simap/SaoScope/hardware/SaoScope.kicad_pcb

## KiCad design hardware/SaoScope.kicad_pcb (2024-10-12)

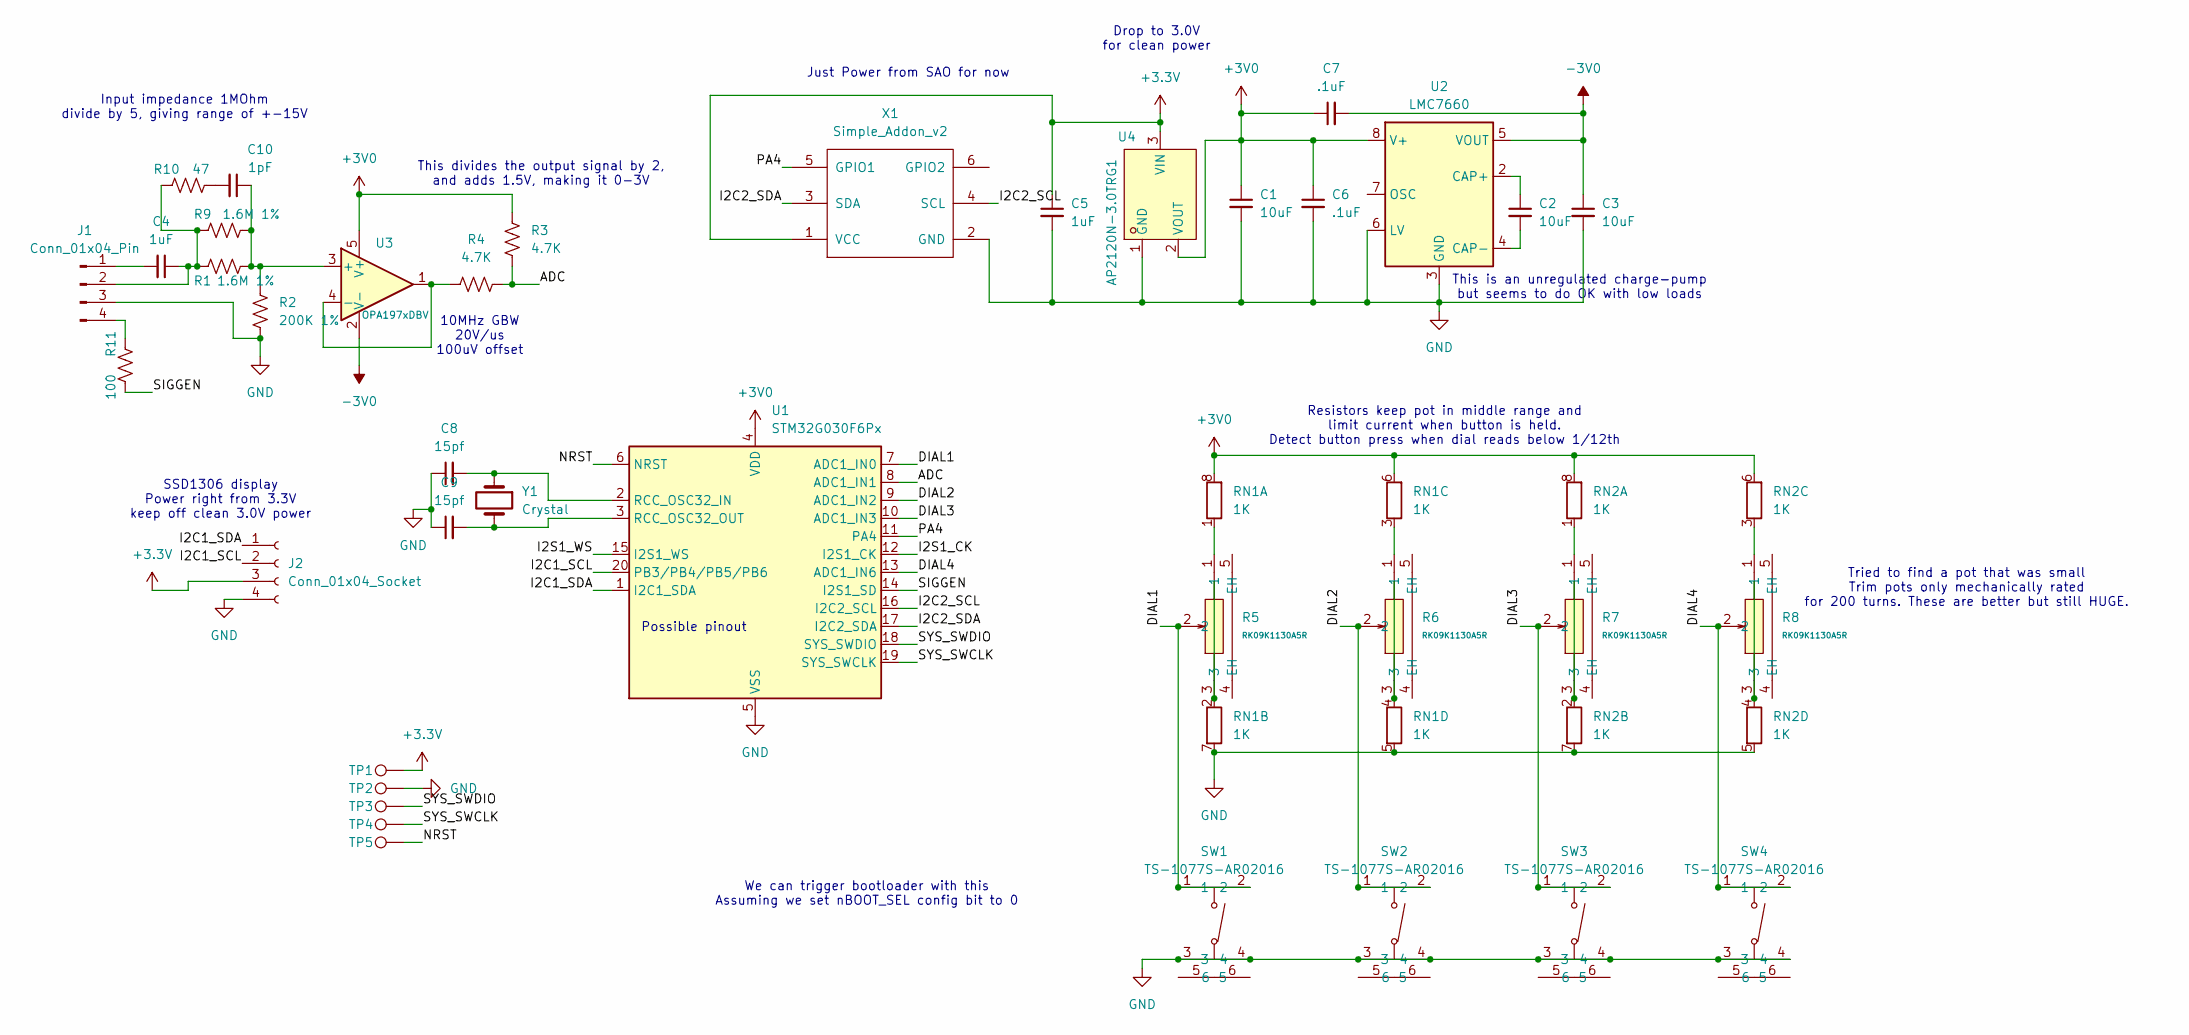
[picture p1: schematic SaoScope.kicad_sch]

Parts:
C1, C2, C3: 10uF; C_0805_2012Metric
C4, C5: 1uF; C_0603_1608Metric
C6, C7: .1uF; C_0402_1005Metric
C8, C9: 15pf; C_0402_1005Metric
C10: 1pF; C_0402_1005Metric
J1: Conn_01x04_Pin; PinHeader_1x04_P2.54mm_Vertical
J2: Conn_01x04_Socket; ssd1306_module
R1, R9: 1.6M 1%; R_0402_1005Metric; LCSC Part C172161
R2: 200K 1%; R_0402_1005Metric; LCSC Part C25764
R3, R4: 4.7K; R_0402_1005Metric
R5, R6, R7, R8: RK09K1130A5R; RES-ADJ-TH_RK09K1130A5R; LCSC Part C209779
R10: 47; R_0402_1005Metric; LCSC Part C172161
R11: 100; R_0402_1005Metric; LCSC Part C172161
RN1, RN2: 1K; R_Array_Convex_4x0402; LCSC Part C2769475
SW1, SW2, SW3, SW4: TS-1077S-AR02016; KEY-SMD_4P-L3.1-W3.1-P2.00-LS4.0; LCSC Part C720462
TP1, TP2, TP3, TP4, TP5: TestPoint; TestPoint_Pad_1.5x1.5mm
U1: STM32G030F6Px; TSSOP-20_4.4x6.5mm_P0.65mm
U2: LMC7660; SOP-8_3.9x4.9mm_P1.27mm
U3: OPA197xDBV; SOT-23-5
U4: AP2120N-3.0TRG1; SOT-23-3_L2.9-W1.3-P1.90-LS2.4-BR; LCSC Part C460318
X1: Simple_Addon_v2; Simple_Addon_v2-SAO-2x3
Y1: Crystal; Crystal_SMD_3215-2Pin_3.2x1.5mm; LCSC Part C5213671

Connections:
+3.3V: C5.1, J2.3, TP1.1, U4.3 (VIN), X1.1 (VCC)
+3V0: C1.1, C6.1, C7.1, R3.2, RN1.6 (R3.2), RN1.8 (R1.2), RN2.6 (R3.2), RN2.8 (R1.2), U1.4 (VDD), U2.8 (V+), U3.5 (V+), U4.2 (VOUT)
-3V0: C3.1, C7.2, U2.5 (VOUT), U3.2 (V-)
/ADC: R3.1, R4.2, U1.8 (ADC1_IN1)
/DIAL1: R5.2, SW1.1, SW1.2, U1.7 (ADC1_IN0)
/DIAL2: R6.2, SW2.1, SW2.2, U1.9 (ADC1_IN2)
/DIAL3: R7.2, SW3.1, SW3.2, U1.10 (ADC1_IN3)
/DIAL4: R8.2, SW4.1, SW4.2, U1.13 (ADC1_IN6)
/I2C1_SCL: J2.2, U1.20 (PB3/PB4/PB5/PB6)
/I2C1_SDA: J2.1, U1.1 (I2C1_SDA)
/I2C2_SCL: U1.16 (I2C2_SCL), X1.4 (SCL)
/I2C2_SDA: U1.17 (I2C2_SDA), X1.3 (SDA)
/I2S1_CK: U1.12 (I2S1_CK)
/I2S1_WS: U1.15 (I2S1_WS)
/NRST: TP5.1, U1.6 (NRST)
/PA4: U1.11 (PA4), X1.5 (GPIO1)
/SIGGEN: R11.2, U1.14 (I2S1_SD)
/SYS_SWCLK: TP4.1, U1.19 (SYS_SWCLK)
/SYS_SWDIO: TP3.1, U1.18 (SYS_SWDIO)
GND: C1.2, C3.2, C5.2, C6.2, C8.1, C9.1, J1.3, J2.4, R2.2, RN1.5 (R4.2), RN1.7 (R2.2), RN2.5 (R4.2), RN2.7 (R2.2), SW1.3, SW1.4, SW2.3, SW2.4, SW3.3, SW3.4, SW4.3, SW4.4, TP2.1, U1.5 (VSS), U2.3 (GND), U2.6 (LV), U4.1 (GND), X1.2 (GND)
unnamed: C10.2, R10.2
unnamed: C4.2, J1.1
unnamed: C4.1, J1.2, R1.1, R9.1, R10.1
unnamed: J1.4, R11.1
unnamed: R5.1, RN1.1 (R1.1)
unnamed: R5.3, RN1.2 (R2.1)
unnamed: R6.1, RN1.3 (R3.1)
unnamed: R6.3, RN1.4 (R4.1)
unnamed: R7.1, RN2.1 (R1.1)
unnamed: R7.3, RN2.2 (R2.1)
unnamed: R8.1, RN2.3 (R3.1)
unnamed: R8.3, RN2.4 (R4.1)
unnamed: C8.2, U1.2 (RCC_OSC32_IN), Y1.1
unnamed: C9.2, U1.3 (RCC_OSC32_OUT), Y1.2
unnamed: C2.1, U2.2 (CAP+)
unnamed: C2.2, U2.4 (CAP-)
unnamed: C10.1, R1.2, R2.1, R9.2, U3.3 (+)
unnamed: R4.1, U3.1, U3.4 (-)

Notes on the sheet:
We can trigger bootloader with this Assuming we set nBOOT_SEL config bit to 0
Resistors keep pot in middle range and limit current when button is held. Detect button press when dial reads below 1/12th
This divides the output signal by 2, and adds 1.5V, making it 0-3V
SSD1306 display Power right from 3.3V keep off clean 3.0V power
Just Power from SAO for now
Tried to find a pot that was small Trim pots only mechanically rated for 200 turns. These are better but still HUGE.
Drop to 3.0V for clean power
This is an unregulated charge-pump but seems to do OK with low loads
Possible pinout
Input impedance 1MOhm divide by 5, giving range of +-15V
10MHz GBW 20V/us 100uV offset

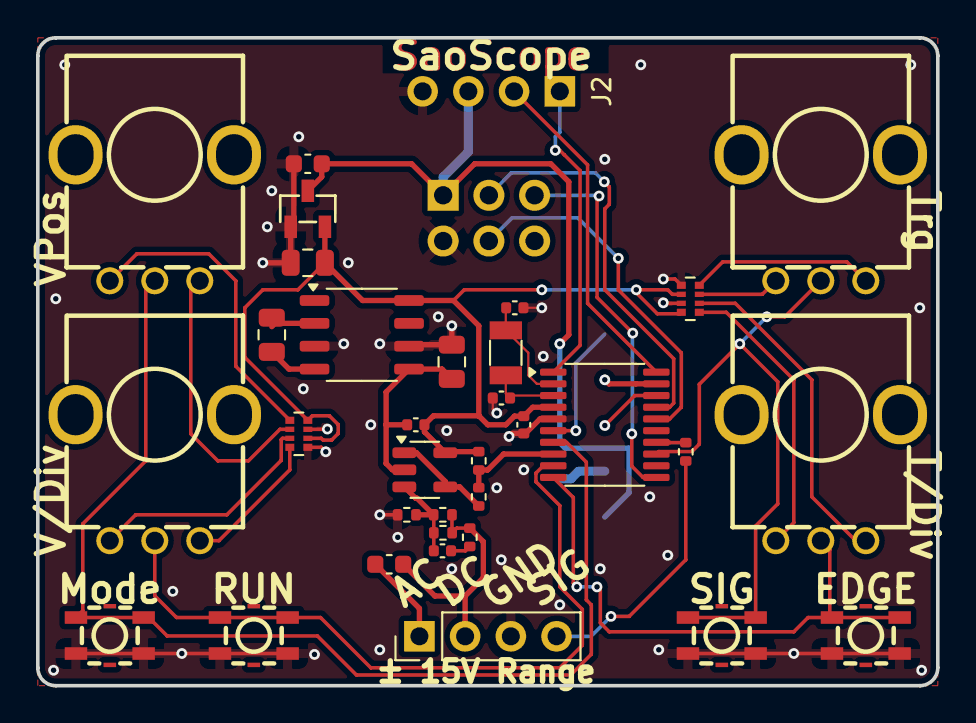
[picture p2: board SaoScope.kicad_pcb from above]

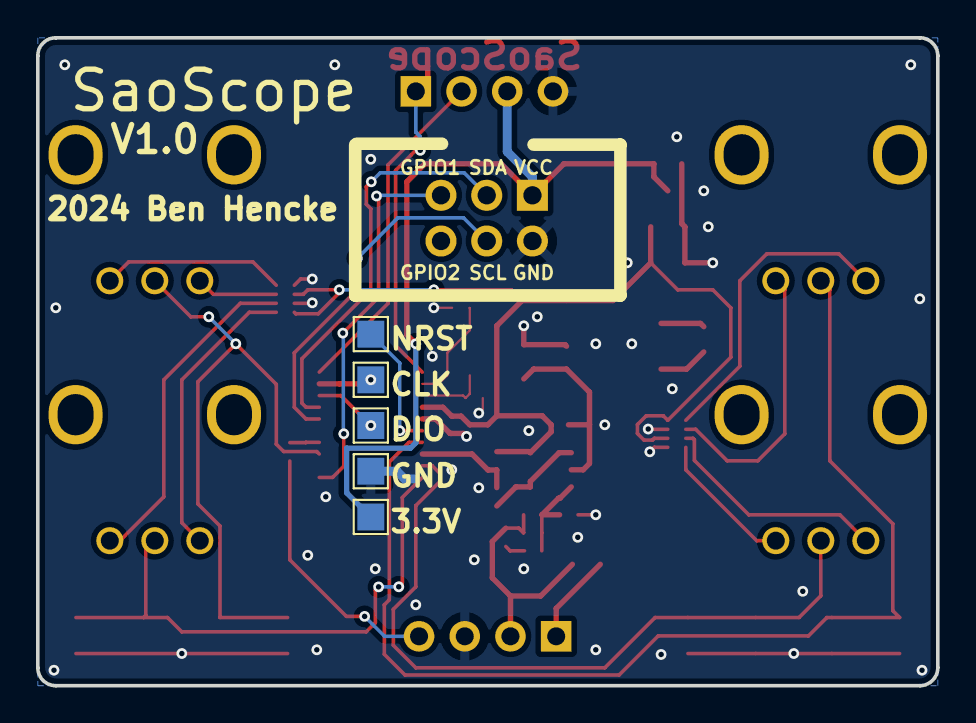
[picture p3: board SaoScope.kicad_pcb from below]

Board: 2 copper layers, 50.0 x 36.0 mm, 40 parts (5 on the bottom side), 36 nets.
