simap/SaoScope/firmware/SaoScope.ioc

Mcu.UserName=STM32G030F6Px
PA0.GPIO_Label=DIAL1
PA0.Signal=ADC1_IN0
PA1.GPIO_Label=SCOPE
PA1.Signal=ADC1_IN1
PA13.Signal=SYS_SWDIO
PA14-BOOT0.Signal=SYS_SWCLK
PA2.GPIO_Label=DIAL2
PA2.Signal=ADC1_IN2
PA3.GPIO_Label=DIAL3
PA3.Signal=ADC1_IN3
PA4.Signal=GPIO_Input
PA5.Signal=I2S1_CK
PA6.GPIO_Label=DIAL4
PA6.Signal=ADC1_IN6
PA7.Signal=SharedStack_PA7
PB0.Signal=I2S1_WS
PB6.Signal=I2C1_SCL
PB7.Signal=I2C1_SDA
