simap/SaoScope/firmware/Core/Inc/main.h

#define DIAL1_Pin LL_GPIO_PIN_0
#define DIAL1_GPIO_Port GPIOA
#define SCOPE_Pin LL_GPIO_PIN_1
#define SCOPE_GPIO_Port GPIOA
#define DIAL2_Pin LL_GPIO_PIN_2
#define DIAL2_GPIO_Port GPIOA
#define DIAL3_Pin LL_GPIO_PIN_3
#define DIAL3_GPIO_Port GPIOA
#define DIAL4_Pin LL_GPIO_PIN_6
#define DIAL4_GPIO_Port GPIOA
