simap/SaoScope/firmware/Core/Src/app.c

/*
 * app.c
 *
 *  Created on: Dec 7, 2022
 *      Author: benh
 */

#include "main.h"
#include "app.h"

#include "ssd1306.h"
#include "ssd1306_tests.h"

#include "sampler.h"
#include "scope.h"
#include "button.h"
#include "dial.h"

#include "stdio.h"

Sampler sampler;
ScopeSettings scope;
ButtonState modeButton, runButton, edgeButton, signalButton;
DialState vposDial, vdivDial, tdivDial, triggerDial;
volatile uint32_t ticks;
uint32_t vdd;

const uint32_t nsDivSequence[] = {500, 1000, 2000, 5000, 10000, 20000, 50000, 100000, 200000, 500000, 1000000, 2000000, 5000000, 10000000};
const uint32_t signalGenFrequencies[] = {20, 50, 100, 200, 500, 1000, 2000, 5000, 10000, 20000, 50000, 100000, 200000, 500000};
const uint32_t vdivStepsMv[] = {100, 200, 500, 1000, 2000, 5000};

int signalGenIndex = 7;
uint32_t messageTimer;
char message[32];

uint32_t getCycles() {
	return SysTick->VAL;
}

void systickISR() {
	ticks++;
	adcManagerSystickISR();
}

uint32_t getTicks() {
	return ticks;
}

void delay(uint32_t ms) {
	uint32_t timer = ticks;
	while (ticks - timer < ms) {
		//wait
	}
}

void delayCycles(uint32_t c) {
	uint32_t timer = SysTick->VAL;
	while (SysTick->VAL - timer < c) {
		//wait
	}
}


void displayMessage(char *msg) {
	strncpy(message, msg, sizeof(message));
	messageTimer = ticks;
}


void displayTriggerLevelMessage() {
	if (abs(scope.triggerLevelUv) < 1000000)
		snprintf(message, sizeof(message), "Trg:  %4dmV", scope.triggerLevelUv/1000);
	else
		snprintf(message, sizeof(message), "Trg:%3d.%02dV", scope.triggerLevelUv/1000000, abs(scope.triggerLevelUv/10000) % 100);
	messageTimer = ticks;
}

void displaySignalGenMessage() {
	int freq = signalGenFrequencies[signalGenIndex];
	if (freq < 1000)
		snprintf(message, sizeof(message), "Sig: %3dHz", freq);
	else
		snprintf(message, sizeof(message), "Sig: %3dKHz", freq/1000);
	messageTimer = ticks;
}

void displayVdivMessage(int vdivMv) {
	if (vdivMv < 1000)
		snprintf(message, sizeof(message), "V/div:  %3dmV", vdivMv);
	else
		snprintf(message, sizeof(message), "V/div: %3d.%02dV", vdivMv/1000, (vdivMv/10) % 100);
	messageTimer = ticks;
}

void run() {

	//pause all peripherals and clocks in debug
	DBG->APBFZ1 = 0xffffffff;
	DBG->APBFZ2 = 0xffffffff;



	scope.mode = CONTINUOUS;
	scope.runMode = RUNNING;


	buttonInit(&modeButton, BUTTON_DEBOUNCE_COUNT, BUTTON_HOLD_COUNT);
	buttonInit(&runButton, BUTTON_DEBOUNCE_COUNT, BUTTON_HOLD_COUNT);
	buttonInit(&edgeButton, BUTTON_DEBOUNCE_COUNT, BUTTON_HOLD_COUNT);
	buttonInit(&signalButton, BUTTON_DEBOUNCE_COUNT, BUTTON_HOLD_COUNT);

	dialInit(&vposDial, 0x8000, 3500, 100);
	dialInit(&vdivDial, 0x8000, 3500, 100);
	// dialInit(&tdivDial, 0x8000, 3500, 100);
	dialInit(&tdivDial, 0x8000, 3500, sizeof(nsDivSequence)/sizeof(nsDivSequence[0]));

	dialInit(&triggerDial, 0x8000, 3500, 256);


	LL_SYSTICK_EnableIT();

	delay(10);

	initSampler(&sampler);
	adcManagerSetup();

	//set up TIM14 signal generation on PA7
	LL_GPIO_SetPinSpeed(GPIOA, LL_GPIO_PIN_7, LL_GPIO_SPEED_FREQ_VERY_HIGH);
	LL_GPIO_SetPinMode(GPIOA, LL_GPIO_PIN_7, LL_GPIO_MODE_ALTERNATE);
	LL_GPIO_SetAFPin_0_7(GPIOA, LL_GPIO_PIN_7, LL_GPIO_AF_4); //set to TIM14_CH1

	LL_TIM_OC_SetMode(TIM14, LL_TIM_CHANNEL_CH1, LL_TIM_OCMODE_PWM1);

    setSignalGen();

    LL_TIM_EnableAllOutputs(TIM14);
	LL_TIM_CC_EnableChannel(TIM14, LL_TIM_CHANNEL_CH1);
	LL_TIM_EnableCounter(TIM14);


	//HACK speed up i2c, well above spec, but it works. about 1.25mhz
	LL_I2C_Disable(I2C1);
	LL_I2C_SetTiming(I2C1, __LL_I2C_CONVERT_TIMINGS(
			0, //PRESCALER
			1, //SETUP_TIME
			0, //HOLD_TIME
			6, //SCLH_PERIOD
			12 //SCLL_PERIOD
	));
	LL_I2C_Enable(I2C1);


	ssd1306_Init();
	ssd1306_SetContrast(0xff);


    int frame = 0;
    uint32_t frameTimer = ticks;
    volatile int fps = 0;
    int pwm;
	uint32_t rate = 1750000;
	int32_t sampleScale = 0x10000;
	int32_t vdivScale = 0x10000;
	int32_t vdivMv, vdivValue;
	int vposOffset = 0;

	SSD1306_COLOR flickering = White;

    for(;;) {
		adcManagerLoop();
//		ssd1306_TestFPS();

    	if (ticks - frameTimer >= 1000) {
    		fps = frame;
    		frameTimer += 1000;
    		frame = 0;
    	}

		if (dialPollChangeEvent(&tdivDial)) {
			int tmp = tdivDial.steps - dialGetValue(&tdivDial) - 1;
			// tmp = (tmp * tmp)/96;
			// rate = tmp * 17500;

			// rate = tmp * tmp * 175;

			//tdiv is ns per 16 samples, convert this to hz
			rate = 16000000000l / nsDivSequence[tmp];

			// if (rate < 13672)
			// 	rate = 13672;
			// if (rate > 1750000)
			// 	rate = 1750000;
			
			setSampleRate(&sampler, rate > 1750000 ? 1750000 : rate); //for now, limit rate until we have everything set up to handle different bit depths
			//TODO scope stepping is usually 1, 2, 5, 10, 20, 50, 100, etc. thats a step of 2x, 2.5x, 2x, 2x, 2.5x, 2x, etc
		}

		sampleScale = ((int64_t)sampler.snapshotSampleRate<<16) / rate;

		if (dialPollChangeEvent(&vposDial)) {
			int32_t tmp = dialGetValue(&vposDial);
			tmp -= vposDial.steps/2;
			vposOffset = 32 + (abs(tmp) * tmp / 4);
		}
		
		if (dialPollChangeEvent(&vdivDial)) {
			int tmp = dialGetValue(&vdivDial);
			// tmp = tmp*tmp;
			if (tmp < 1)
				tmp = 1;
			vdivScale = (0x20000) / tmp;

			//at this scale, how many mv/div are we showing in 16 pixels?
			volatile int mv = adcToUv((16<<16) / vdivScale + 2047) / 1000;

			//find the closest mv/div setting for this scale, shooting for 16 pixels per div. 
			int best = 0;
			int bestDiff = INT32_MAX;
			for (int i = 0; i < sizeof(vdivStepsMv)/sizeof(vdivStepsMv[0]); i++) {
				int diff = abs(vdivStepsMv[i] - mv);
				if (diff < bestDiff) {
					bestDiff = diff;
					best = i;
				}
			}
			vdivMv = vdivStepsMv[best];
			vdivValue = uvToAdc(vdivMv * 1000) - 2047;
			// displayVdivMessage(vdivMv);
		}



		// int vdiv = dialGetValue(&vdivDial);
		// int vpos = dialGetValue(&vposDial);

		
		if (1) {
			int32_t tmp = triggerDial.steps - dialGetValue(&triggerDial);
			tmp -= triggerDial.steps/2;
			//use an exponential scale to get a more useful range. on the top we need +- 15v
			//tmp^2 is up to 16384
			scope.triggerLevelUv = abs(tmp) * tmp * (15000000 / 16384);
		}
		if (dialPollChangeEvent(&triggerDial)) {
			displayTriggerLevelMessage();
		}
		int triggerSampleValue = uvToAdc(scope.triggerLevelUv) - 2048;
		// int triggerValue = dialGetValue(&triggerDial) * 40 - 2048;
		

		if (buttonPollClickEvent(&runButton)) {
			scope.runMode = scope.runMode == STOPPED ? RUNNING : STOPPED;
		}

		if (buttonPollClickEvent(&modeButton)) {
			int next = scope.mode + 1;
			if (next > SINGLE)
				next = CONTINUOUS;
			setScopeMode(next);
		}

		if (buttonPollClickEvent(&edgeButton)) {
			scope.triggerSlope = scope.triggerSlope == RISING ? FALLING : RISING;
		}

		if (buttonPollClickEvent(&signalButton)) {
			signalGenIndex++;
			if (signalGenIndex >= sizeof(signalGenFrequencies)/sizeof(signalGenFrequencies[0]))
				signalGenIndex = 0;
			setSignalGen();
			displaySignalGenMessage();
		}

		//draw scope

        ssd1306_Fill(Black);

		int32_t minVoltage = INT32_MAX;
		int32_t maxVoltage = INT32_MIN;


		//refine edge detection
#if 1
		int start = -1;
		for (int x = SAMPLE_BUFFER_SIZE/2 - 20; x < SAMPLE_BUFFER_SIZE/2 + 20; x++) {
			int sample = getSample(&sampler, x);

			if (scope.triggerSlope == RISING) {
				if (start == -1 && sample < triggerSampleValue) {
					start = x;
				}

				if (start >= 0 && sample > triggerSampleValue) {
					start = x;
					break;
				}
			} else {
				if (start == -1 && sample > triggerSampleValue) {
					start = x;
				}

				if (start >= 0 && sample < triggerSampleValue) {
					start = x;
					break;
				}
			}
			
		}

		if (start < 64 || start > 800)
			start = 512;
#else
		int start = SAMPLE_BUFFER_SIZE/2;
#endif

		start -= (64 * sampleScale) >> 16;
		// start -= 64;


		SSD1306_COLOR blink = (getTicks() & 0x80) ? White : Black;
		flickering = (getTicks() & 0x20) ? White : Black;
		
		for (int x = 0; x < SSD1306_WIDTH; x++) {
			int32_t graphSamplePosition = (x * sampleScale) + (start<<16);
			if (graphSamplePosition < 0)
				continue;
			if (graphSamplePosition >> 16 >= SAMPLE_BUFFER_SIZE -1)
				break;
			int sample = getInterpolatedSample(&sampler, graphSamplePosition);

			// int sample = getSample(&sampler, x + start);
			int mv = 15000 * sample / 2048;

			if (mv > maxVoltage)
				maxVoltage = mv;
			if (mv < minVoltage)
				minVoltage = mv;

			// int y = vpos - sample/vdiv;
			int y = vposOffset - ((sample * vdivScale) >> 16);

//				int y = 31 - sample/100;
			SSD1306_COLOR color = White;
			if (y > 63) {
				y = 63;
				color = blink;
			} else if (y < 0) {
				y = 0;
				color = blink;
			}
			ssd1306_DrawPixel(x, y , color);
		}



		//draw center line showing trigger time
		// for (int y = 0; y < 48; y += 8) {
		// 	ssd1306_DrawPixel(64, y, flickering);
		// 	// ssd1306_DrawPixel(0, y, flickering);
		// 	// ssd1306_DrawPixel(127, y, flickering);
		// }

		//draw vdiv dots
		for (int i = -5; i < 5; i++) {
			int yOffset = ((i * vdivValue * vdivScale) >> 16);
			// ssd1306_DrawPixel(64, vposOffset - yOffset, White);

			//draw these every 16 pixels, 8 for ground line
			int increment = i == 0 ? 8: 16;
			for (int x = 0; x < 128; x += increment) {
				int y = vposOffset - yOffset;
				if (y > 56) //skip area with text
					continue;
				ssd1306_DrawPixel(x, y, flickering);
			}
		}

		//draw trigger threshold line
		{
			int y = vposOffset - ((triggerSampleValue * vdivScale) >> 16);
			for (int x = 0; x < SSD1306_WIDTH; x += 4) {
				// ssd1306_DrawPixel(x, vpos - triggerValue/vdiv, flickering);
				//now from triggerLevelUv. convering microvolts to ADC value
				// int y = vposOffset - triggerSampleValue/vdiv;
				ssd1306_DrawPixel(x, y, flickering);
			}
		}

		// //draw ground line every 8 pixels
		// for (int x = 0; x < 128; x += 8) {
		// 	ssd1306_DrawPixel(x, vposOffset, White);
		// }





    	// if (run) {
    	// 	startSampler(&sampler);
    	// }

		/* screen design, 21 chars wide

		|---------------------|
		| plot area		      | y = 0-7
		|                     | y = 8-15
		|                     | y = 16-23
		|                     | y = 24-31
		|                     | y = 32-39
		|                     | y = 40-47
		|< messages | stats  >| y = 48-55
		|1.0v 100ms  SCAN R _/|	y = 56-63
		|---------------------|

		*/

		char buff[64];

		const int yStart = 48;
		ssd1306_SetCursor(1, yStart);

		// ssd1306_FillRectangle(0, 15 + yStart, 127, 32 + yStart, White);
		int Vp = (maxVoltage - minVoltage)/10;
		int VpVolts = Vp/100;
		int VpHv = (Vp - VpVolts*100);

		if (message[0] != 0) {
			if (ticks - messageTimer < 2000) {
				ssd1306_WriteString(message, Font_6x8, White);
			} else {
				message[0] = 0;
			}
		} else {
			//TODO show stats, like Vp, Vrms, frequency, etc
			// snprintf(buff, sizeof(buff), "Vdd:%dmv  FPS: %d", vdd, fps);
			// ssd1306_WriteString(buff, Font_6x8, White);
		}

		//show key scope settings
		


		// snprintf(buff, sizeof(buff), "%d, %d, %d, %d ", dialGetValue(&vposDial), dialGetValue(&vdivDial), dialGetValue(&tdivDial), dialGetValue(&triggerDial));
		// ssd1306_SetCursor(1, 24 + yStart);
		// ssd1306_WriteString(buff, Font_6x8, White);

		// ssd1306_WriteString(modeButton.isHeld ? "H" : modeButton.isDown ? "O" : "-", Font_6x8, White);
		// ssd1306_WriteString(runButton.isHeld ? "H" : runButton.isDown ? "O" : "-", Font_6x8, White);
		// ssd1306_WriteString(edgeButton.isHeld ? "H" : edgeButton.isDown ? "O" : "-", Font_6x8, White);
		// ssd1306_WriteString(signalButton.isHeld ? "H" : signalButton.isDown ? "O" : "-", Font_6x8, White);


		ssd1306_SetCursor(1, 8 + yStart);

		const char * modeStr = scope.mode == CONTINUOUS ? "SCAN" : scope.mode == NORMAL ? "NORM" : "SING";
		const char * runStr = scope.runMode == STOPPED ? "S" : "R";
		const char * edgeStr = scope.triggerSlope == RISING ? "_/" : "\\_";

		ssd1306_WriteString(modeStr, Font_6x8, White);
		ssd1306_WriteString(" ", Font_6x8, White);
		ssd1306_WriteString(runStr, Font_6x8, scope.runMode == STOPPED ? blink : White);
		ssd1306_WriteString(" ", Font_6x8, White);
		// snprintf(buff, sizeof(buff), "~%dmv", scope.triggerLevelUv/1000);
		// ssd1306_WriteString(buff, Font_6x8, White);

		int nsdiv = 16000000000l / rate;
		if (nsdiv < 1000) {
			snprintf(buff, sizeof(buff), "%dns", nsdiv);
		} else if (nsdiv < 1000000) {
			snprintf(buff, sizeof(buff), "%dus", nsdiv/1000);
		} else {
			snprintf(buff, sizeof(buff), "%dms", nsdiv/1000000);
		}
		ssd1306_WriteString(buff, Font_6x8, White);

		if (vdivMv < 1000)
			snprintf(buff, sizeof(buff), " .%dV", vdivMv/100);
		else
			snprintf(buff, sizeof(buff), " %dV", vdivMv/1000);
		ssd1306_WriteString(buff, Font_6x8, White);

		ssd1306_SetCursor(112, 8 + yStart);
		ssd1306_WriteString(edgeStr, Font_6x8, White);


		// snprintf(buff, sizeof(buff), "%d, %d, %d, %d ", dialGetValue(&vposDial), dialGetValue(&vdivDial), dialGetValue(&tdivDial), dialGetValue(&triggerDial));
		// ssd1306_WriteString(buff, Font_6x8, White);

		// ssd1306_WriteString(modeButton.isHeld ? "H" : modeButton.isDown ? "O" : "-", Font_6x8, White);
		// ssd1306_WriteString(runButton.isHeld ? "H" : runButton.isDown ? "O" : "-", Font_6x8, White);
		// ssd1306_WriteString(edgeButton.isHeld ? "H" : edgeButton.isDown ? "O" : "-", Font_6x8, White);
		// ssd1306_WriteString(signalButton.isHeld ? "H" : signalButton.isDown ? "O" : "-", Font_6x8, White);



        ssd1306_UpdateScreen();

        frame++;
    }
}

void setSignalGen()
{
    int signalFreq = signalGenFrequencies[signalGenIndex];
	int cycles = SystemCoreClock / signalFreq;
	int prescaler = cycles>> 16;
	if (prescaler > 0) {
		cycles = cycles / (prescaler + 1);
	}
	LL_TIM_SetPrescaler(TIM14, prescaler);

    LL_TIM_SetAutoReload(TIM14, cycles - 1 + 1);
    LL_TIM_OC_SetCompareCH1(TIM14, cycles / 2);
    LL_TIM_GenerateEvent_UPDATE(TIM14);
}
