simap/SaoScope/(commit log)

2024-09-26 wire up pots and buttons, comments
    [SaoScope.kicad_pcb, SaoScope.kicad_sch]
2024-09-27 make fit in 50mm
    [SaoScope.kicad_pcb]
2024-09-27 basic rev
    [SaoScope.kicad_pcb, SaoScope.kicad_sch]
2024-09-27 more graphics/text
    [SaoScope.kicad_pcb]
2024-09-27 bigger holes, rounder edges
    [SaoScope.kicad_pcb]
2024-09-27 blue, text
    [SaoScope.kicad_pcb]
2024-09-27 split faceplate to another file
    [SaoScope faceplate.kicad_pcb, SaoScope.kicad_pcb]
2024-10-07 switch 800k with two 1.6M resistors
    [SaoScope.kicad_pcb, SaoScope.kicad_sch]
2024-10-12 bring in i2c lines from sao, a gpio, and run a sig gen line out. rework button labels.
    [SaoScope.kicad_pcb, SaoScope.kicad_sch]
2024-10-24 fix part number oops
    [SaoScope.kicad_sch]
2024-10-25 scans buttons and dials now
    move adc stuff to adcmanager, add dial helper
    scope sampling is kinda wonky since it doesn't pause sampling to capture a waveform, but will fix that soon
    [adcmanager.c, app.c, app.h, dial.c, dial.h, sampler.c, sampler.h, scope.h]
2024-10-26 wire in some super basic support for vpos, vdiv, tdiv, and run btn
2024-10-31 WIP getting closer to usable, a bit unstable, but most buttons and dials do stuff
    continuous scan works
    trigger dial works with software edge detect
    trigger using adc watchdogs still WIP.
    a bit messy, will need cleanup
    [adcmanager.c, app.c, app.h, sampler.c, sampler.h, scope.c]
2024-10-31 has scope-like t/div increments
    fixed a few other issues.
    disabled sample speeds faster than 1.75msps until time can be spent making things work better when the sample bits change.
    graph can be scaled independent of sample snapshot. so you can stop the scope and zoom in/out, and get sane scope-like t/div increments.
    running the scope starts sampling at a rate that gets at least one sample per pixel if possible.
    normal and single mode still not working, disabled for now.
    better trigger threshold control
    [adcmanager.c, app.c, app.h, sampler.c, sampler.h, scope.c, scope.h]
2024-11-02 fix issue when changing scope mode mid scan, vdiv dots, ui cleanup
    [adcmanager.c, app.c, app.h]
